rxfx/profibusmonitor/GUIDE/Project_Properties_Spartan3.bmp

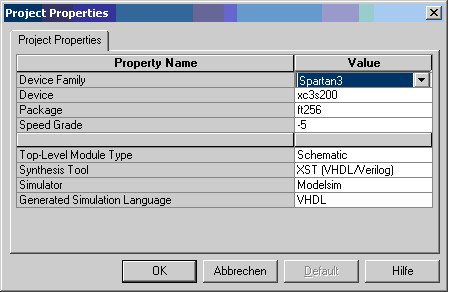
GUIDE/Project_Properties_Spartan3.bmp
