rxfx/profibusmonitor/Schnittstelle_Profibus_Eagle_files_old/PROFIBUS.pdf

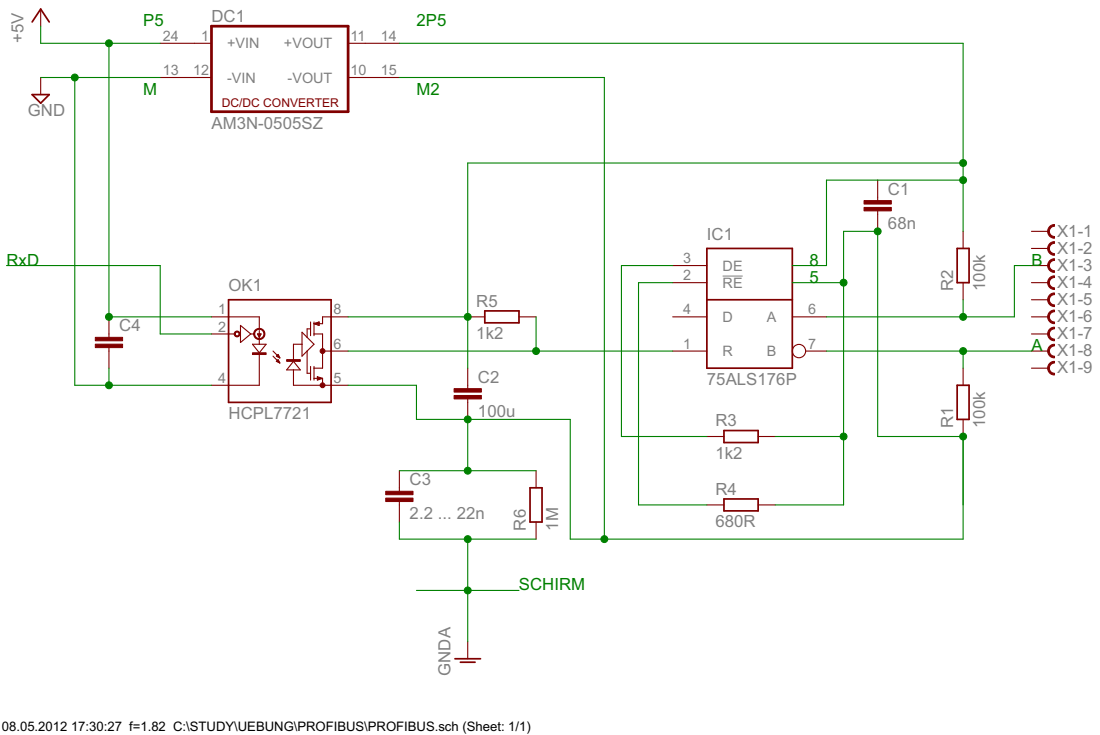
[picture p29: page 1]

08.05.2012 17:30:27 f=1.82 C:\STUDY\UEBUNG\PROFIBUS\PROFIBUS.sch (Sheet: 1/1)
