rxfx/profibusmonitor/Schnittstelle_Profibus_Eagle_files_old/PROFIBUS_V3.pdf

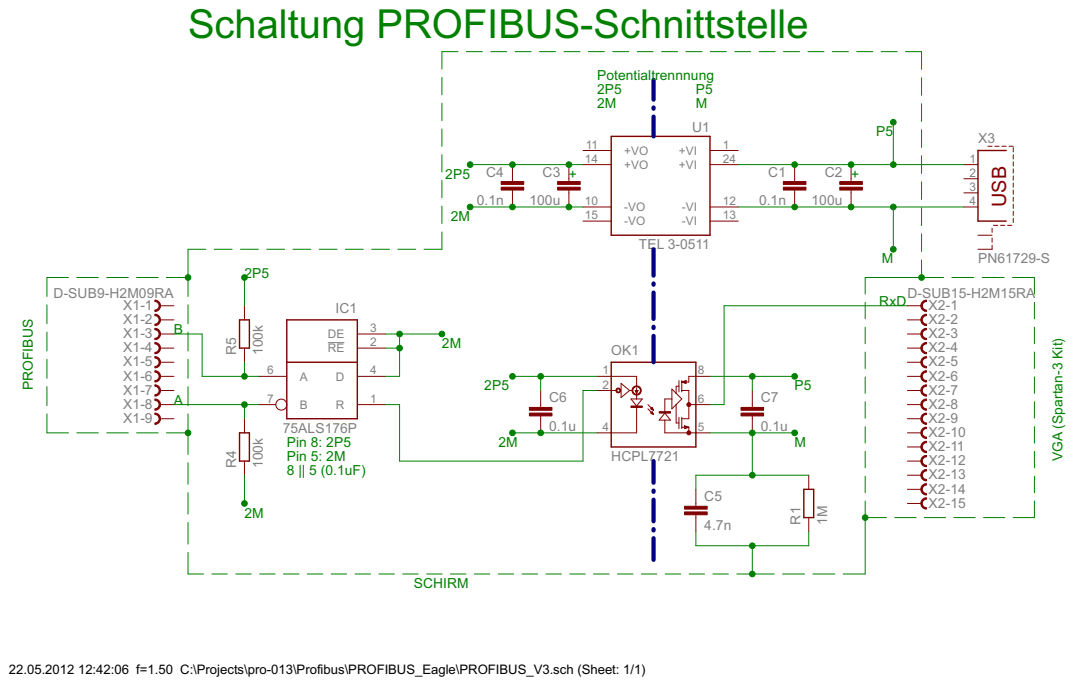
[picture p30: page 1]

22.05.2012 12:42:06 f=1.50 C:\Projects\pro-013\Profibus\PROFIBUS_Eagle\PROFIBUS_V3.sch (Sheet: 1/1)
