rxfx/profibusmonitor/Schnittstelle_Profibus_Eagle_files/PROFIBUS_V5.sch

## EAGLE design Schnittstelle_Profibus_Eagle_files/PROFIBUS_V5.sch (2014-02-25)

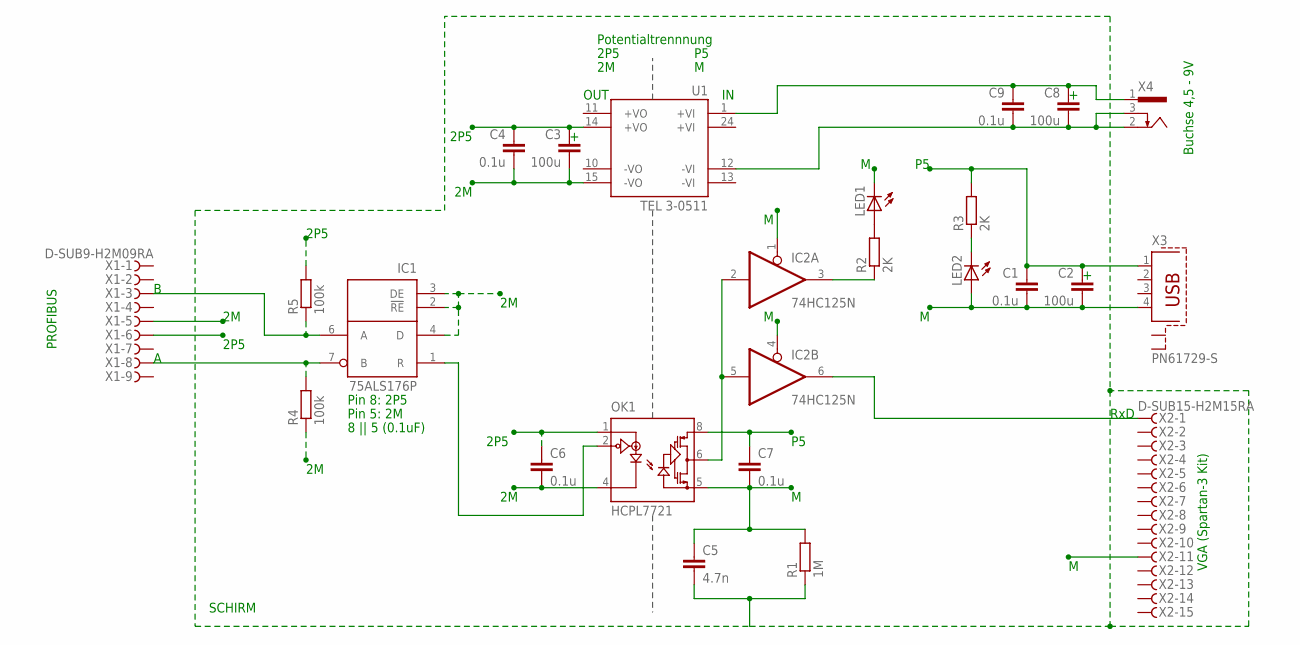
[picture p31: schematic PROFIBUS_V5.sch]

Parts:
C1, C4, C6, C7, C9: 0.1u; C2.5-3
C2, C3, C8: 100u; C2.5-3
C5: 4.7n; C2.5-3
IC1: 75ALS176P; DIL08
IC2: 74HC125N; DIL14
LED1: TLLY4400; LED3MM
LED2: TLLG4400; LED3MM
OK1: HCPL7721; DIL08
R1: 1M; 0204/7
R2, R3: 2K; 0204/7
R4, R5: 100k; 0204/7
U1: TEL 3-0511; AM3N_DIL24
X1: D-SUB9-H2M09RA; H2M09RA
X2: D-SUB15-H2M15RA; H2M15RA
X3: PN61729-S
X4: 733980-62

Connections:
+VO: C3.1, C4.1, U1.14 (+VO)
-VO@2: C3.2, C4.2, U1.15 (-VO)
unnamed: IC1.7 (B), R4.2, X1.8
unnamed: IC1.6 (A), R5.1, X1.3
unnamed: IC1.1 (R), OK1.2 (VI)
unnamed: IC2.2 (I), IC2.5 (I), OK1.6 (VO)
unnamed: IC1.2 (!RE), IC1.3 (DE), IC1.4 (D)
unnamed: C5.2, R1.1
unnamed: LED2.K (C), R3.1
unnamed: C1.2, C2.2, LED2.A, X3.4
unnamed: C6.1, OK1.1 (VDD1)
unnamed: C6.2, OK1.4 (GND1)
unnamed: C7.1, OK1.8 (VDD2)
unnamed: C5.1, C7.2, OK1.5 (GND2), R1.2
unnamed: IC2.6 (O), X2.1
unnamed: LED1.A, R2.2
unnamed: IC2.3 (O), R2.1
unnamed: C1.1, C2.1, R3.2, X3.1
unnamed: C8.2, C9.2, U1.12 (-VI), X4.2, X4.3
unnamed: C8.1, C9.1, U1.1 (+VI), X4.1

Notes on the sheet:
RxD
2P5
SCHIRM
8 || 5 (0.1uF)
PROFIBUS
Potentialtrennnung
VGA (Spartan-3 Kit)
Pin 8: 2P5
Pin 5: 2M
OUT
Buchse 4,5 - 9V
